spacehen/EEE4022F/Report/Fig_18.png

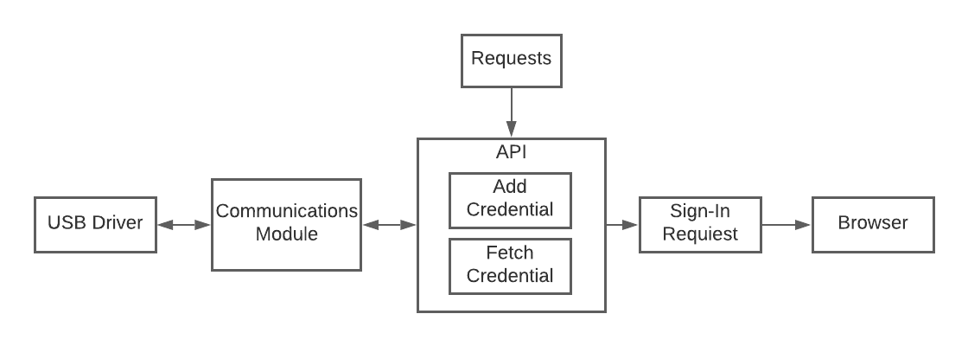
Report/Fig_18.png
