spacehen/EEE4022F/Report/Figures/Fig_01.png

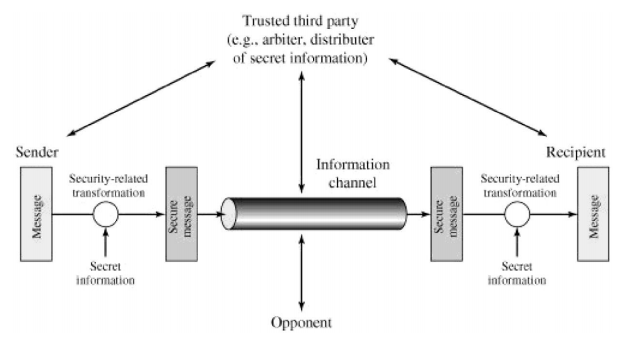
Report/Figures/Fig_01.png
