spacehen/EEE4022F/Report/Figures/Fig_02.png

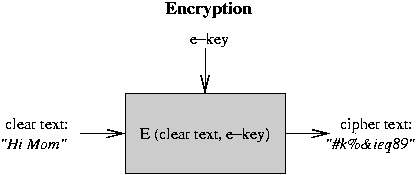
Report/Figures/Fig_02.png
