spacehen/EEE4022F/Report/Figures/Fig_03.png

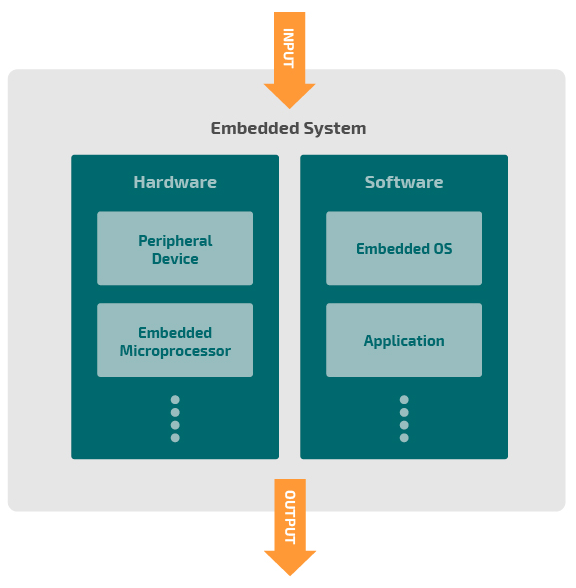
Report/Figures/Fig_03.png
