spacehen/EEE4022F/Report/Figures/Fig_04.png

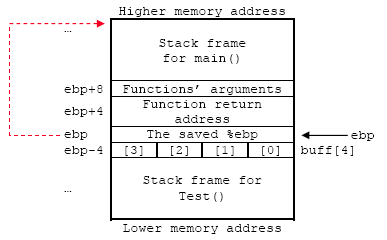
Report/Figures/Fig_04.png
