spacehen/EEE4022F/Report/Figures/Fig_05.png

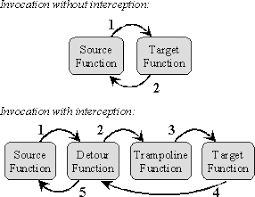
Report/Figures/Fig_05.png
