spacehen/EEE4022F/Report/Figures/Fig_06.png

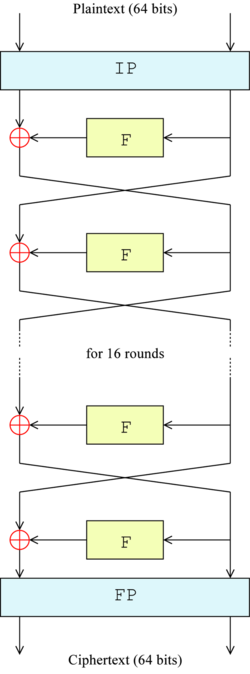
Report/Figures/Fig_06.png
