spacehen/EEE4022F/Report/Figures/Fig_07.png

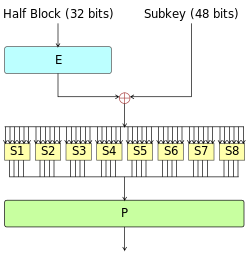
Report/Figures/Fig_07.png
