spacehen/EEE4022F/Report/Figures/Fig_08.jpg

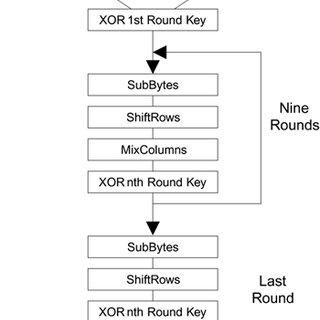
Report/Figures/Fig_08.jpg
