spacehen/EEE4022F/Report/Figures/Fig_09.png

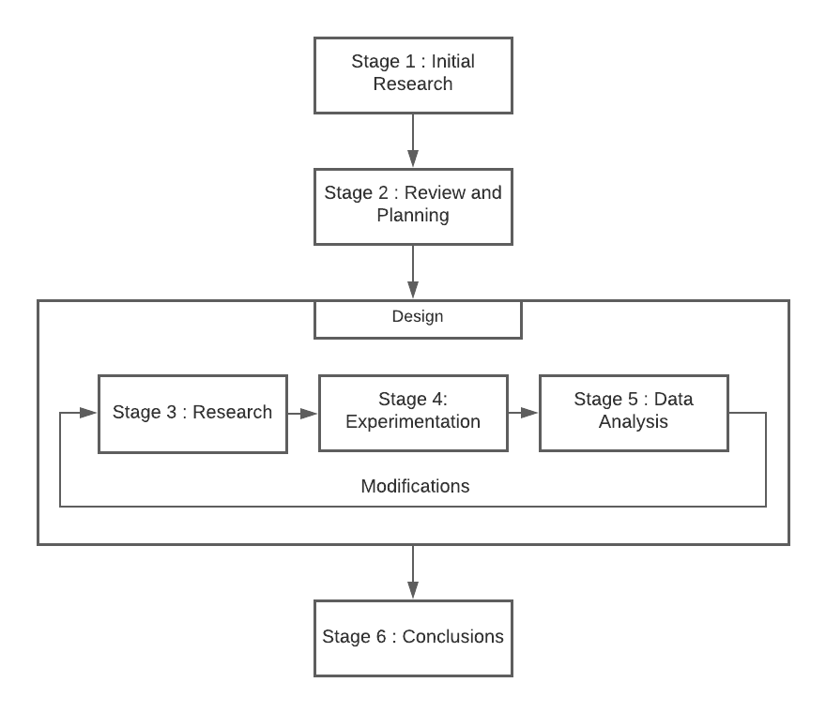
Report/Figures/Fig_09.png
