spacehen/EEE4022F/Report/Figures/Fig_10.png

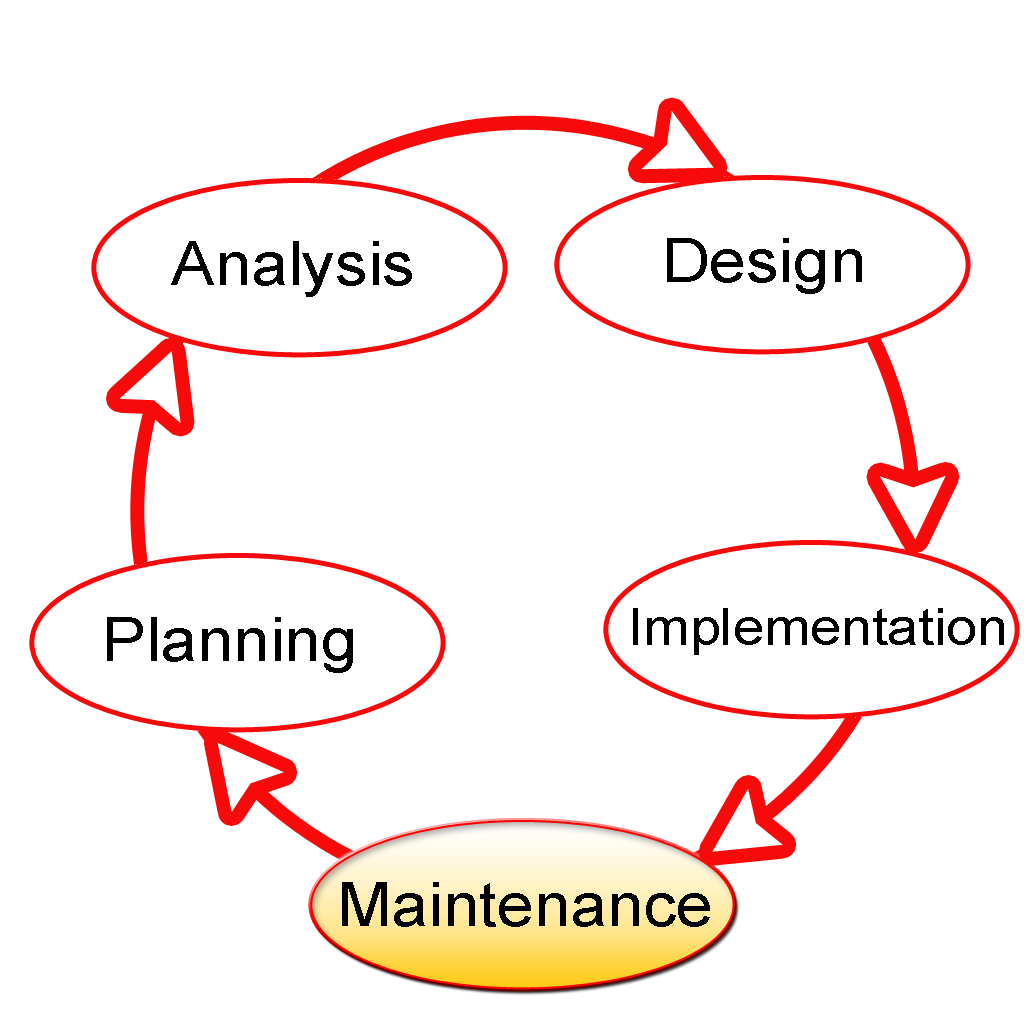
Report/Figures/Fig_10.png
