spacehen/EEE4022F/Report/Figures/Fig_11.png

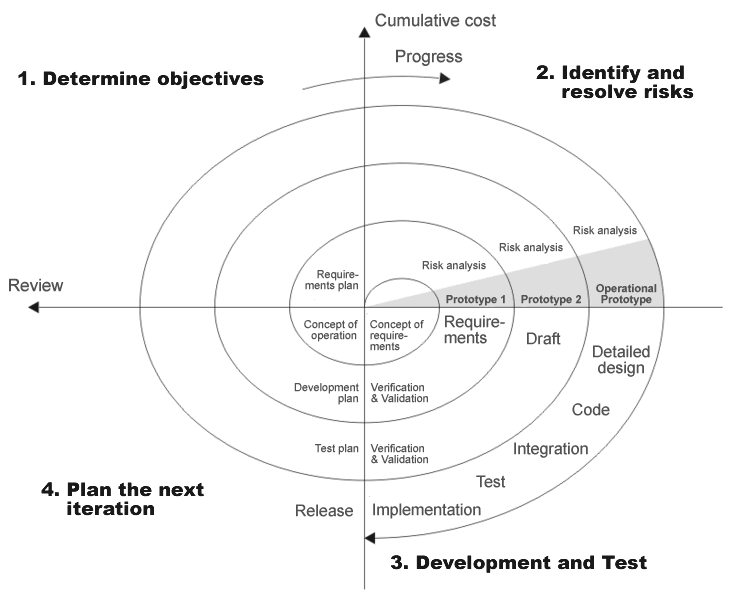
Report/Figures/Fig_11.png
