spacehen/EEE4022F/Report/Figures/Fig_12.png

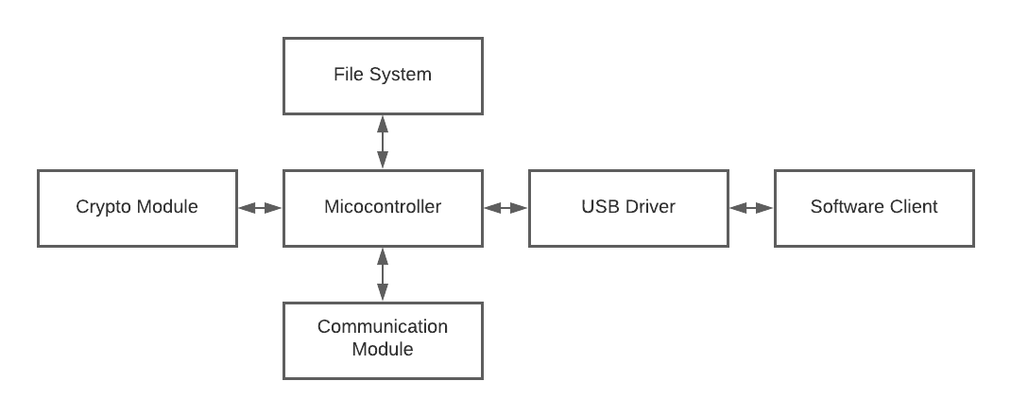
Report/Figures/Fig_12.png
