spacehen/EEE4022F/Report/Figures/Fig_14.jpg

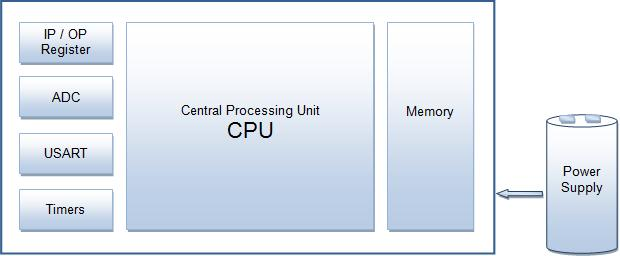
Report/Figures/Fig_14.jpg
