spacehen/EEE4022F/Report/Figures/Fig_15.png

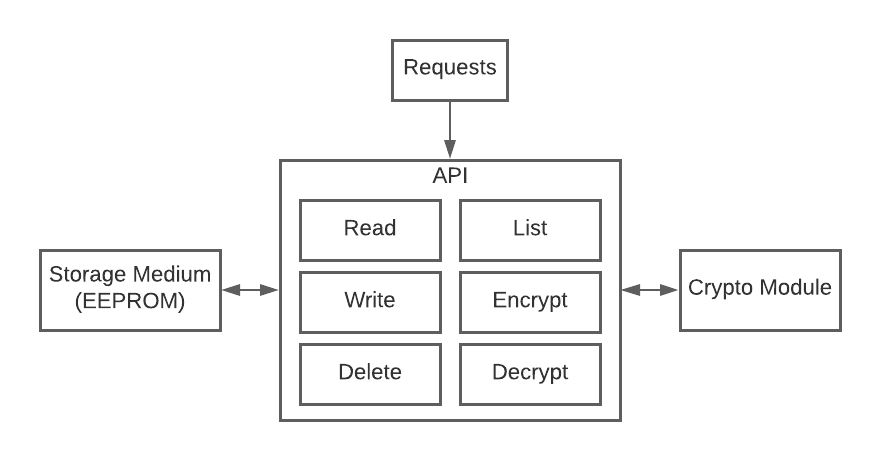
Report/Figures/Fig_15.png
