spacehen/EEE4022F/Report/Figures/Fig_16.png

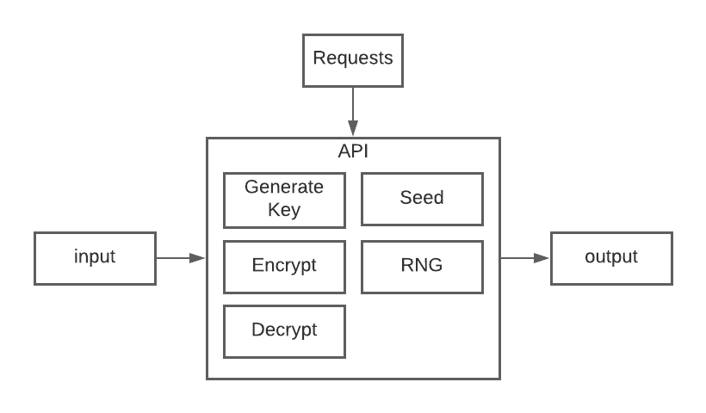
Report/Figures/Fig_16.png
