spacehen/EEE4022F/Report/Figures/Fig_17.png

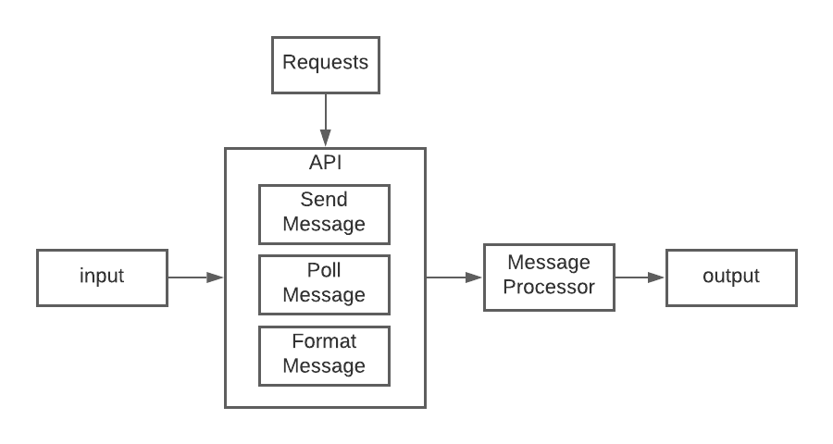
Report/Figures/Fig_17.png
