spacehen/EEE4022F/Report/Figures/Fig_18.png

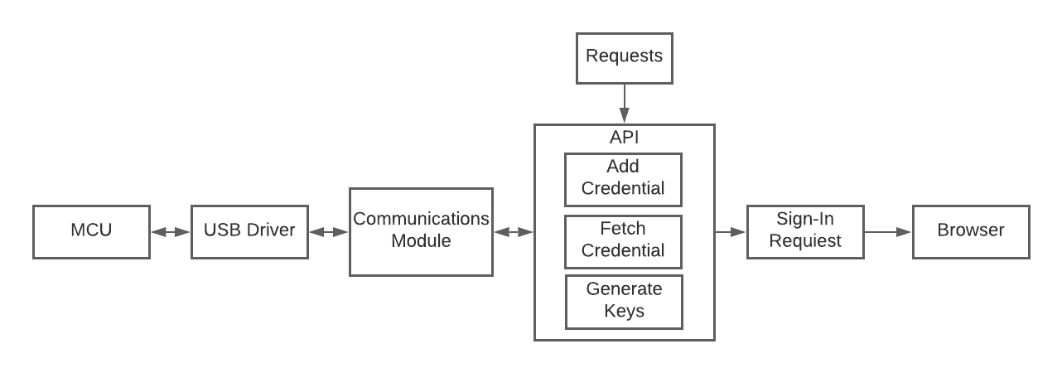
Report/Figures/Fig_18.png
