spacehen/EEE4022F/Report/Figures/Fig_22.png

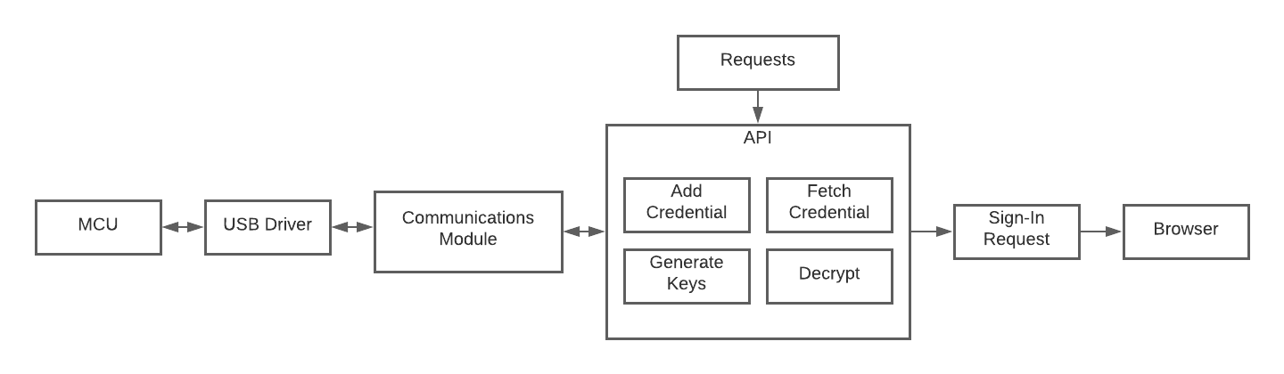
Report/Figures/Fig_22.png
