spacehen/EEE4022F/Report/Figures/Fig_24.png

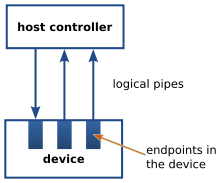
Report/Figures/Fig_24.png
