spacehen/EEE4022F/Report/Figures/Fig_26.png

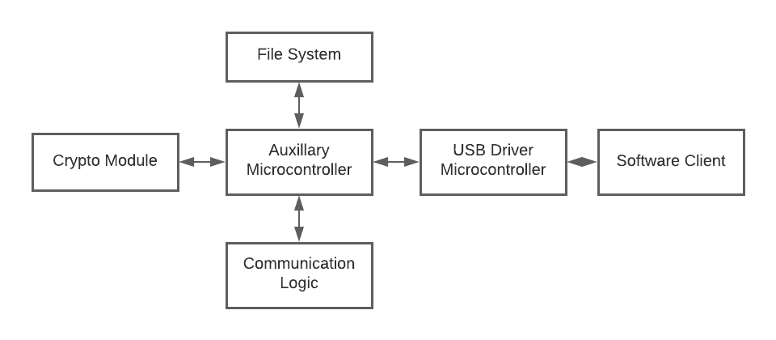
Report/Figures/Fig_26.png
