spacehen/EEE4022F/Report/Figures/Fig_27.png

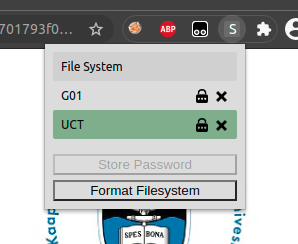
Report/Figures/Fig_27.png
