spacehen/EEE4022F/Report/Figures/Fig_30.png

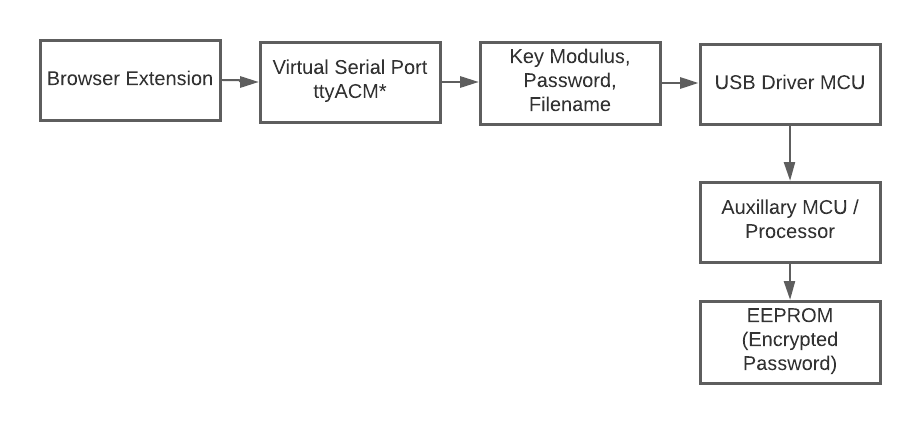
Report/Figures/Fig_30.png
