spacehen/EEE4022F/Report/Figures/Fig_32.png

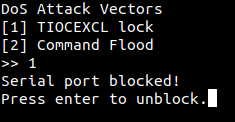
Report/Figures/Fig_32.png
