spacehen/EEE4022F/Report/Figures/Fig_36.png

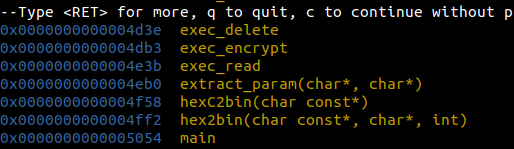
Report/Figures/Fig_36.png
