spacehen/EEE4022F/Report/Figures/Fig_37.png

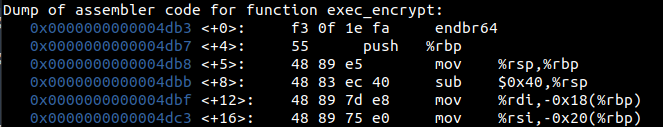
Report/Figures/Fig_37.png
