spacehen/EEE4022F/Report/Figures/Fig_42.png

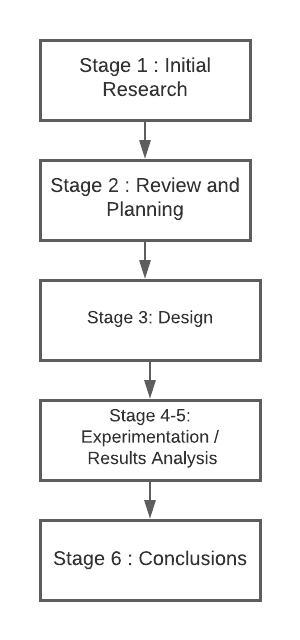
Report/Figures/Fig_42.png
