spacehen/EEE4022F/Report/Figures/Fig_44.png

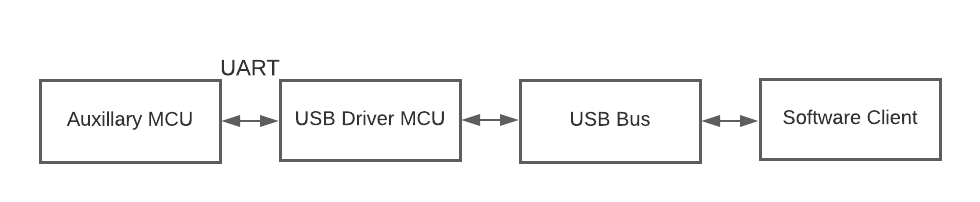
Report/Figures/Fig_44.png
