spacehen/EEE4022F/Report/Figures/Fig_45.png

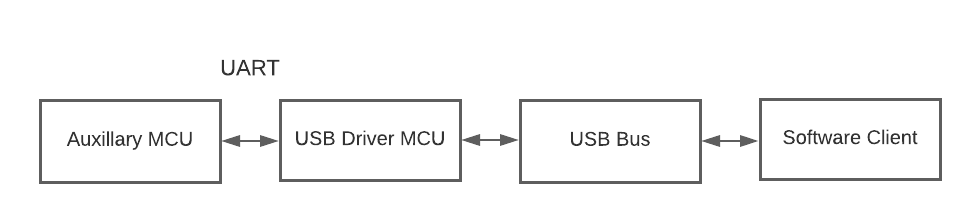
Report/Figures/Fig_45.png
