spacehen/EEE4022F/Report/Figures/Fig_47.png

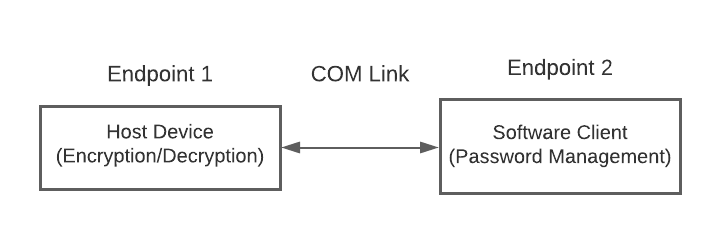
Report/Figures/Fig_47.png
