spacehen/EEE4022F/Report/Figures/Fig_48.png

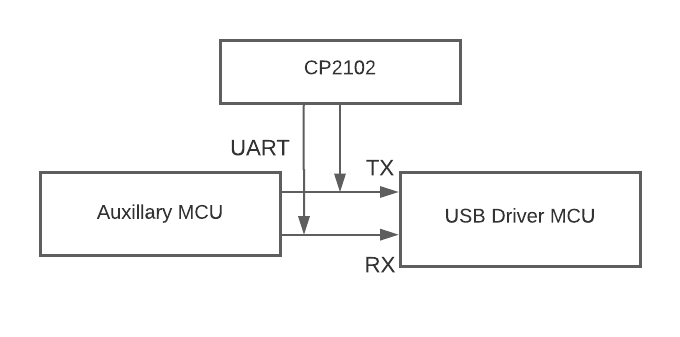
Report/Figures/Fig_48.png
