spacehen/EEE4022F/Report/Figures/Fig_49.png

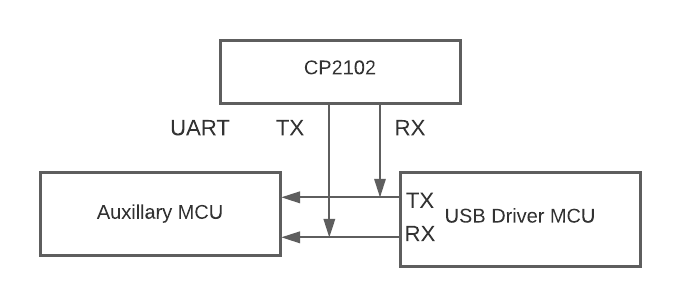
Report/Figures/Fig_49.png
