spacehen/EEE4022F/Report/Figures/Fig_51.png

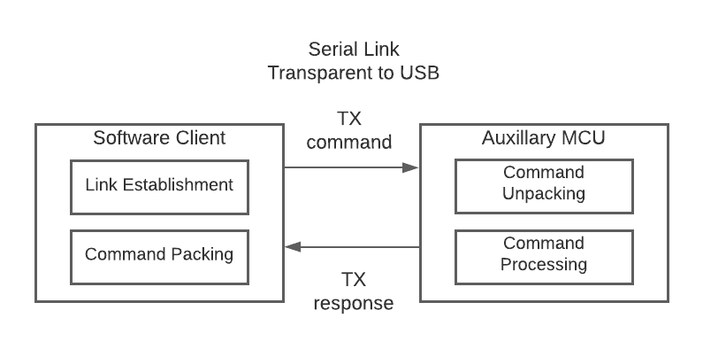
Report/Figures/Fig_51.png
