spacehen/EEE4022F/Report/Figures/Fig_52.png

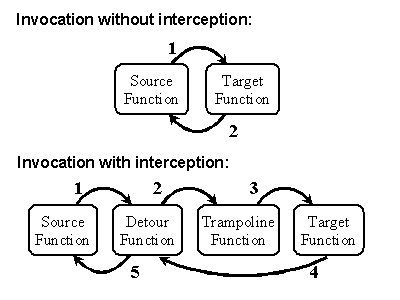
Report/Figures/Fig_52.png
