spacehen/EEE4022F/Report/Figures/FIg_57.png

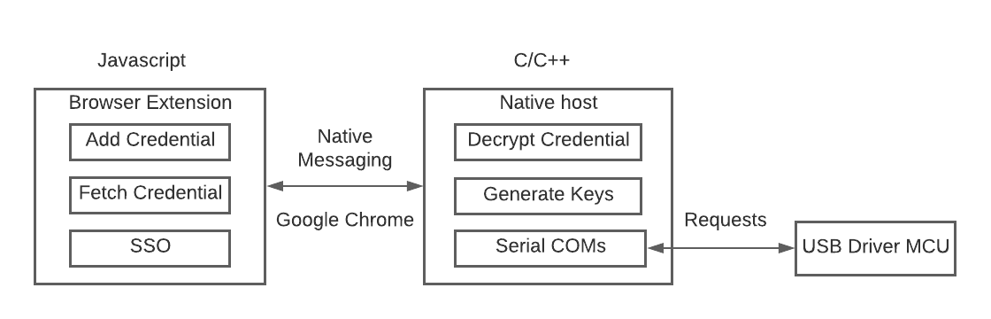
Report/Figures/FIg_57.png
