spacehen/EEE4022F/Report/Figures/Fig_58.png

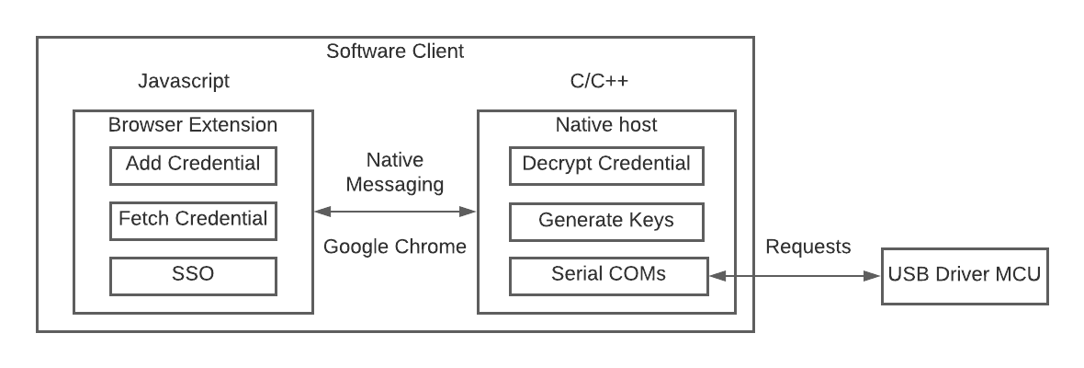
Report/Figures/Fig_58.png
