spacehen/EEE4022F/Report/Figures/Fig_63.png

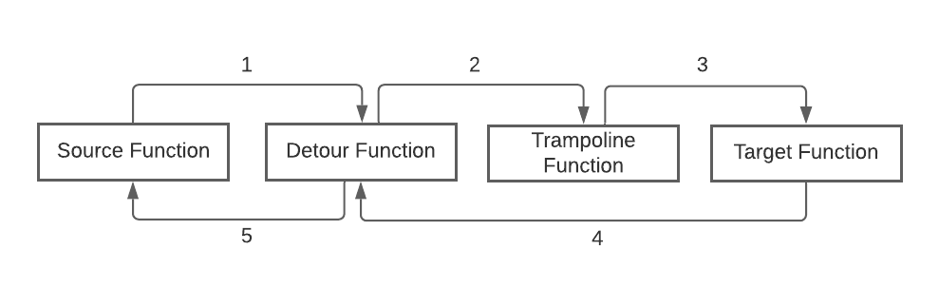
Report/Figures/Fig_63.png
