spacehen/EEE4022F/Report/Figures/Fig_65.png

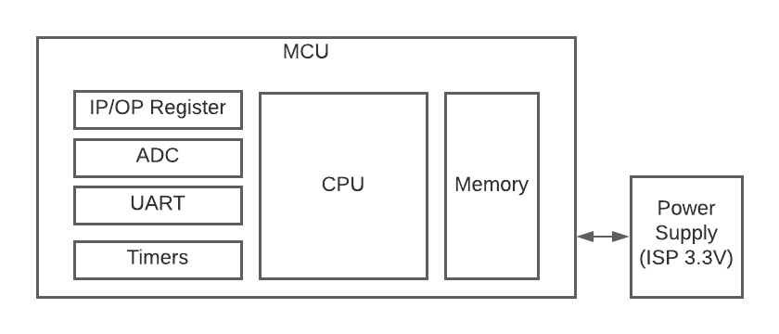
Report/Figures/Fig_65.png
