spacehen/EEE4022F/Report/Figures/Fig_69.png

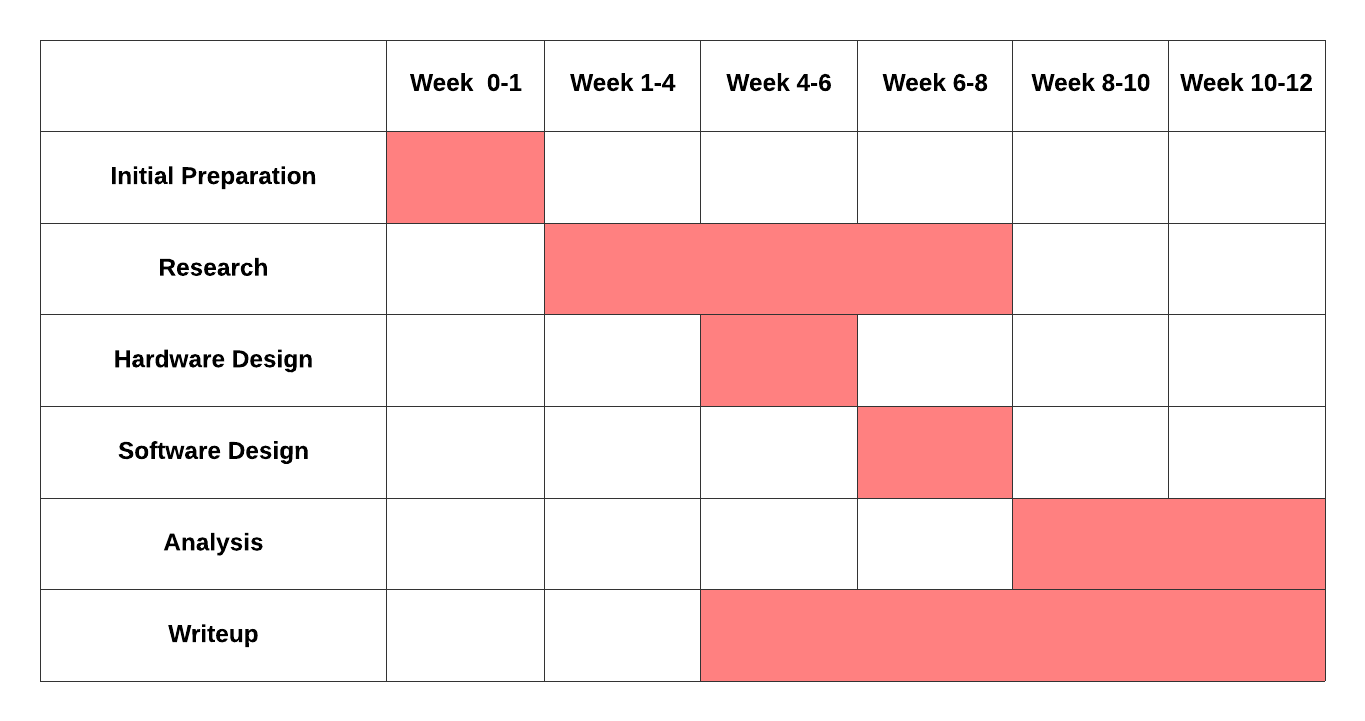
Report/Figures/Fig_69.png
