spacehen/EEE4022F/Report/Figures/Fig_70.png

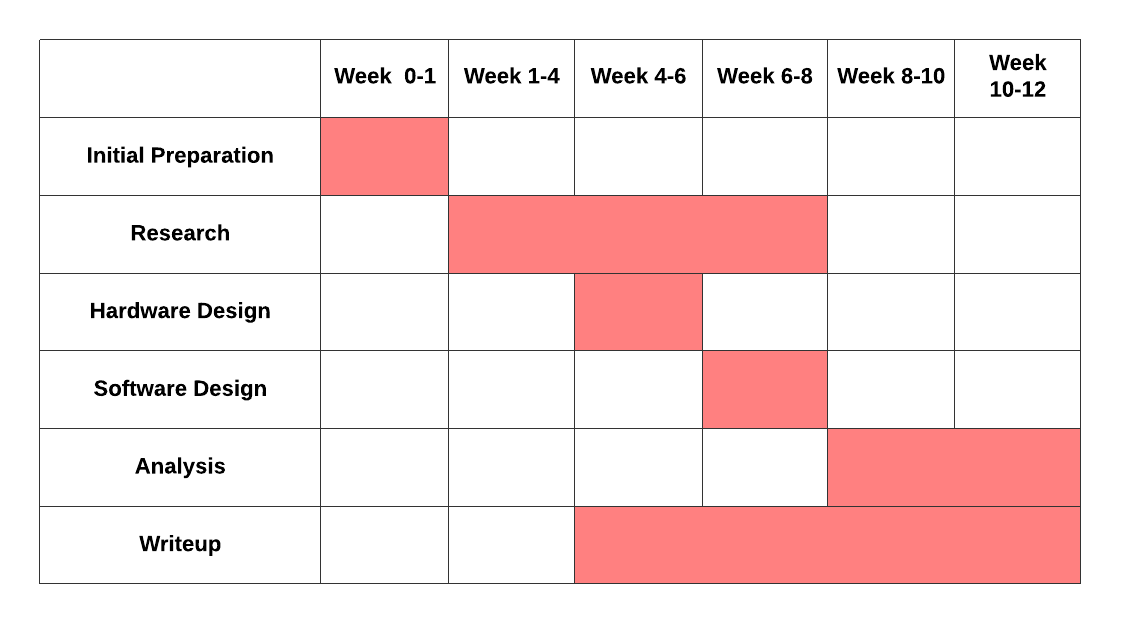
Report/Figures/Fig_70.png
