spacehen/EEE4022F/Report/Figures/Fig_74.png

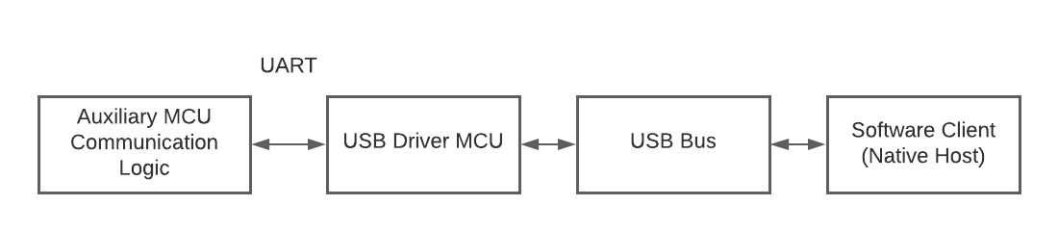
Report/Figures/Fig_74.png
