spacehen/EEE4022F/Report/Figures/Fig_77.png

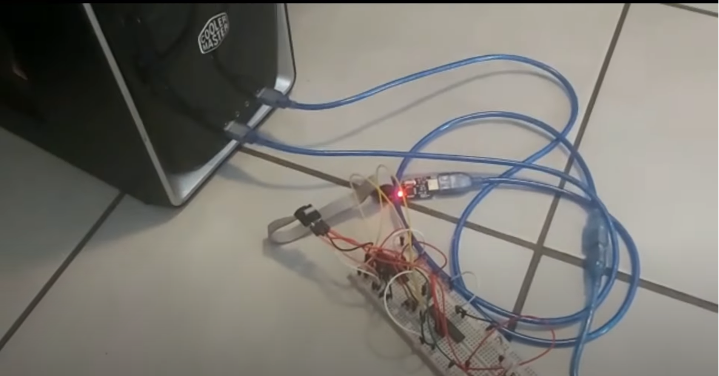
Report/Figures/Fig_77.png
