spacehen/EEE4022F/Report/Figures/Fig_78.png

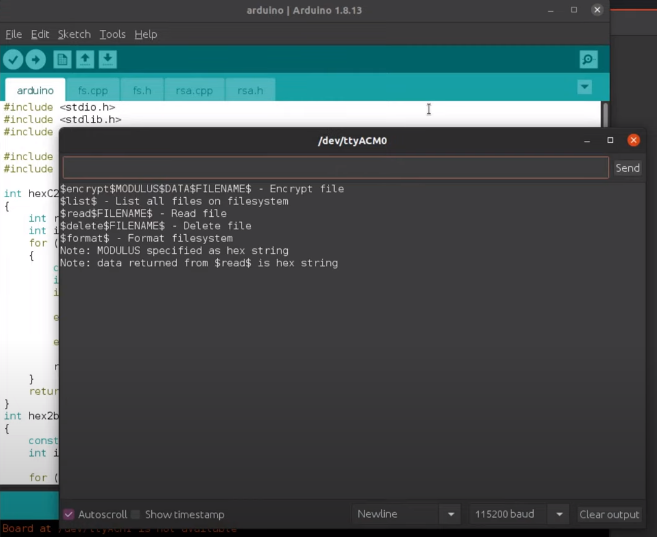
Report/Figures/Fig_78.png
