spacehen/EEE4022F/Report/Figures/Fig_83.png

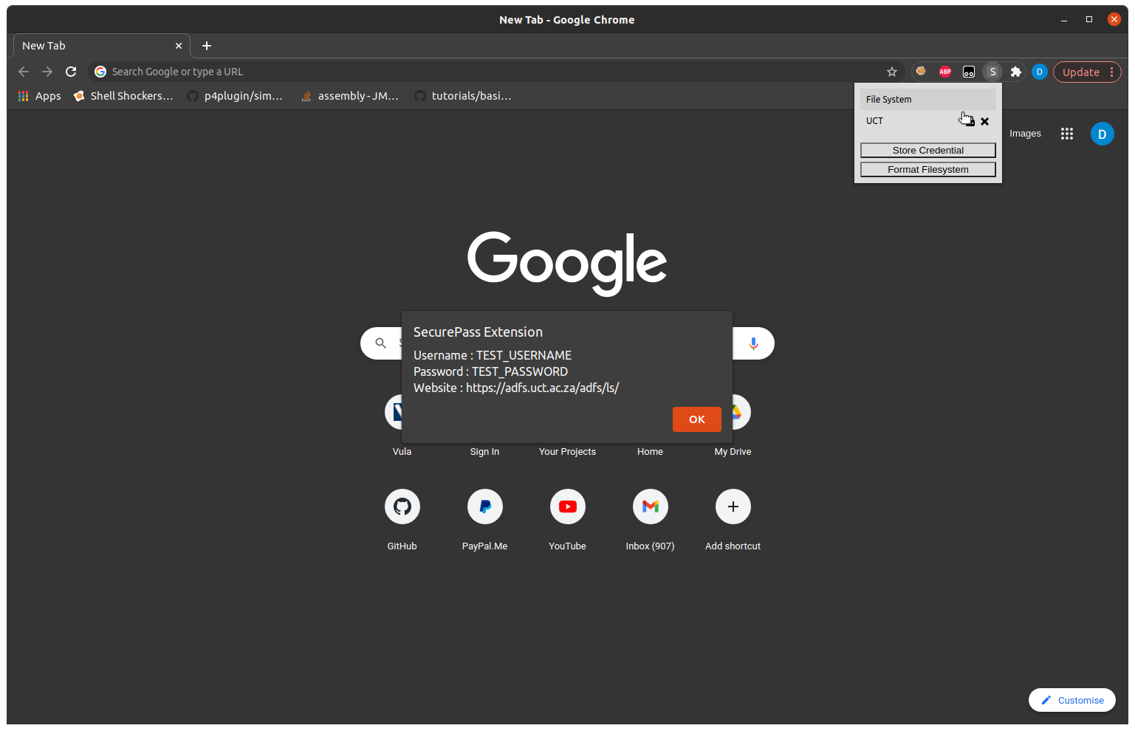
Report/Figures/Fig_83.png
