spacehen/EEE4022F/Report/Figures/Fig_86.png

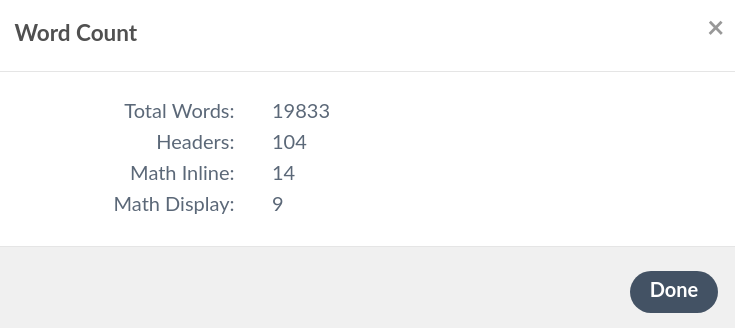
Report/Figures/Fig_86.png
