spacehen/EEE4022F/Report/Figures/Fig_88.png

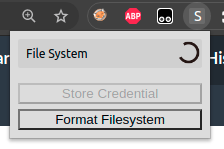
Report/Figures/Fig_88.png
