spacehen/EEE4022F/Report/Figures/UCT.jpg

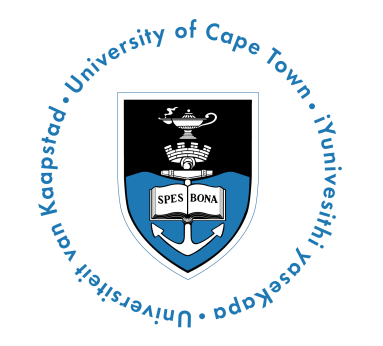
Report/Figures/UCT.jpg
