spacehen/EEE4022F/Software/Browser Extension/load.gif

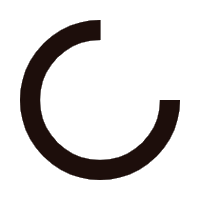
Software/Browser Extension/load.gif
